kimitobo/Lemonster/Photos/Lemonster_TW.jpg

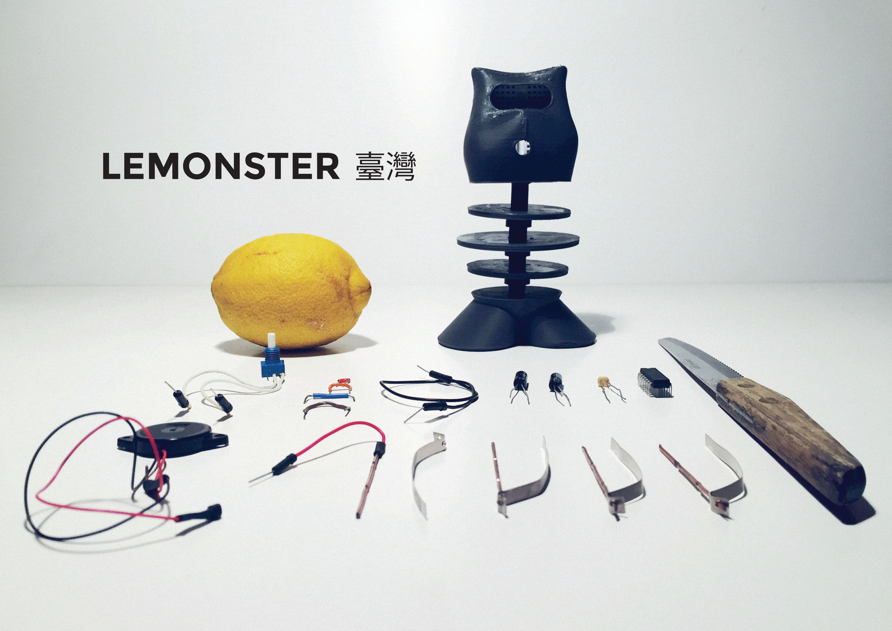
Photos/Lemonster_TW.jpg
