kimitobo/Lemonster/Laser/Lemonster_Laserbody_11mm_2mm.jpg

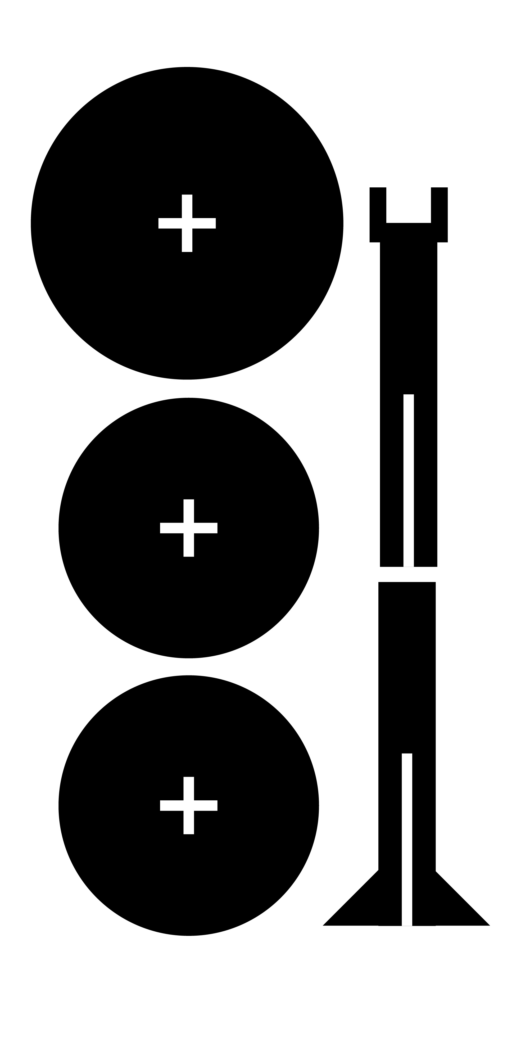
Laser/Lemonster_Laserbody_11mm_2mm.jpg
