kimitobo/Lemonster/Laser/Lemonster_Laserbody_12mm_3mm.jpg

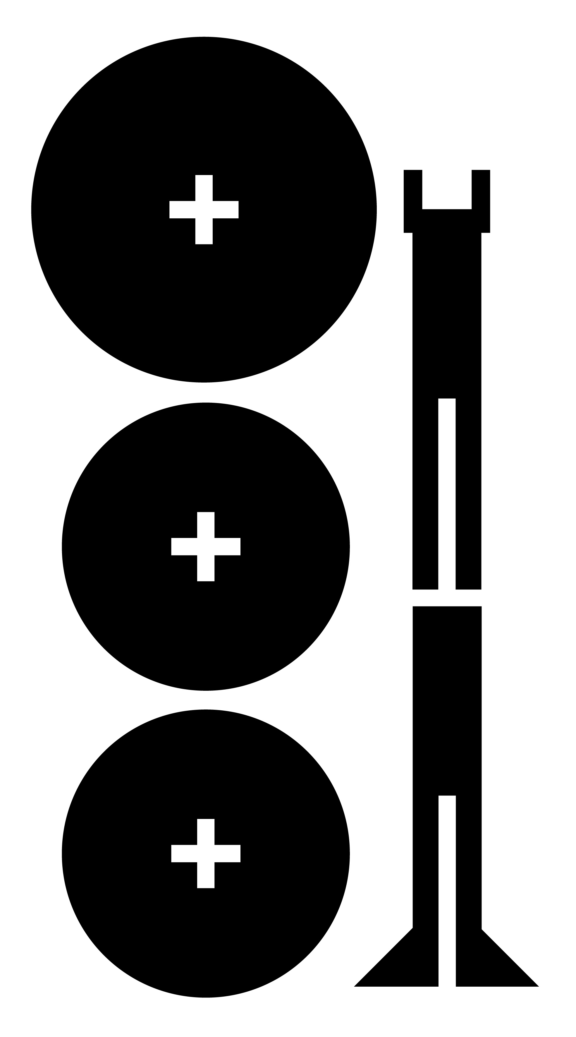
Laser/Lemonster_Laserbody_12mm_3mm.jpg
