kimitobo/Lemonster/STL/Lemonster_1_0_collection_10_5mm-Feet_10_5mm_cross.stl

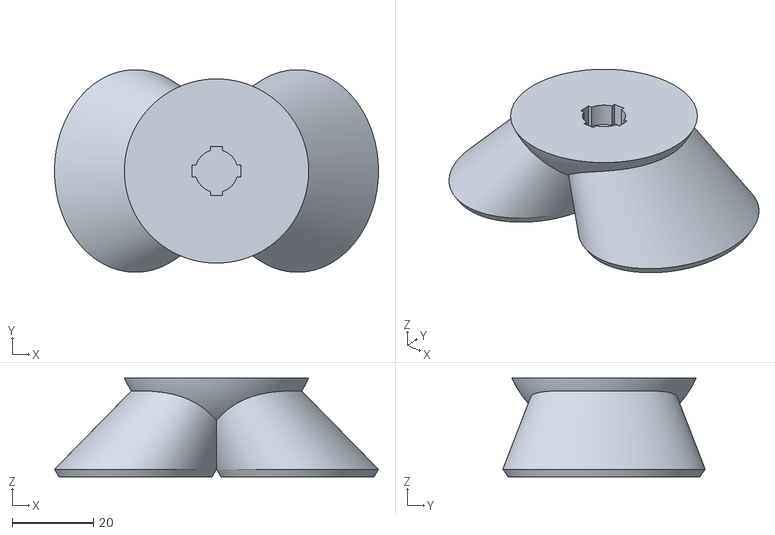
[picture p4: CAD file, 2015-09-28]
STL/Lemonster_1_0_collection_10_5mm-Feet_10_5mm_cross.stl
80.0 x 50.0 x 24.3
