kimitobo/Lemonster/STL/Lemonster_1_0_collection-Head.stl

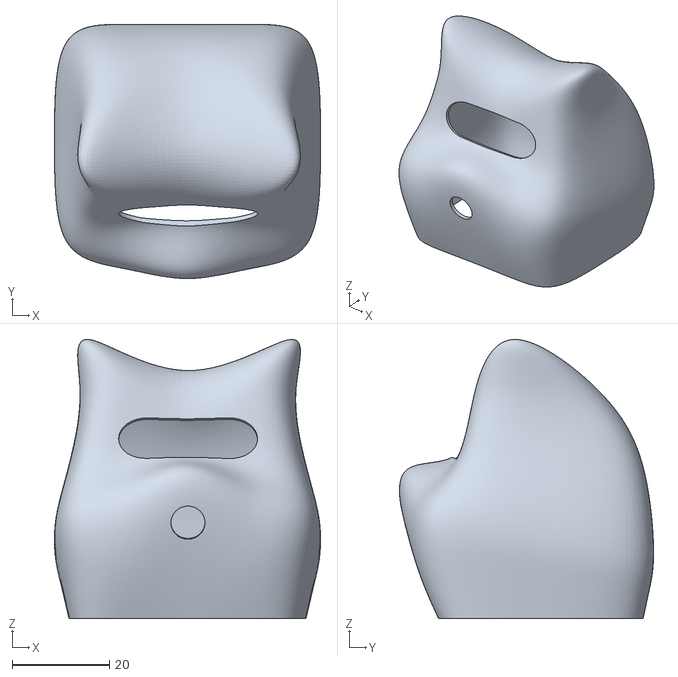
[picture p5: CAD file, 2015-09-28]
STL/Lemonster_1_0_collection-Head.stl
54.6 x 52.2 x 57.3
