kimitobo/Lemonster/STL/Lemonster_1_0_collection_10_5mm-Layer_50mm_10_5mm.stl

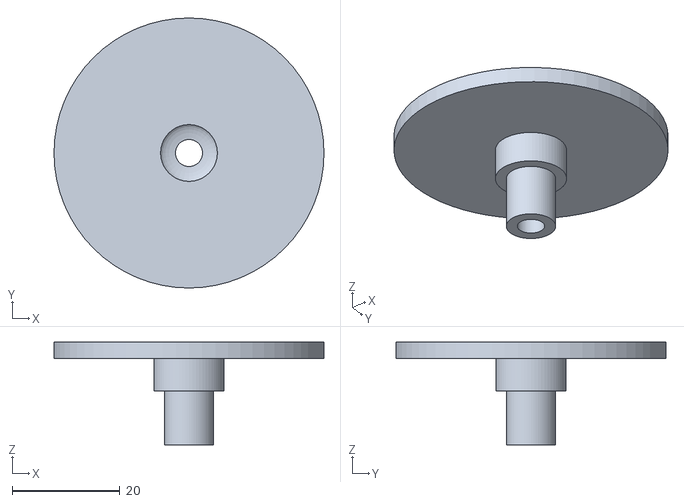
[picture p6: CAD file, 2015-09-28]
STL/Lemonster_1_0_collection_10_5mm-Layer_50mm_10_5mm.stl
50.0 x 50.0 x 19.0
