kimitobo/Lemonster/STL/Lemonster_1_0_collection_10_5mm-LaserTestSocket.stl

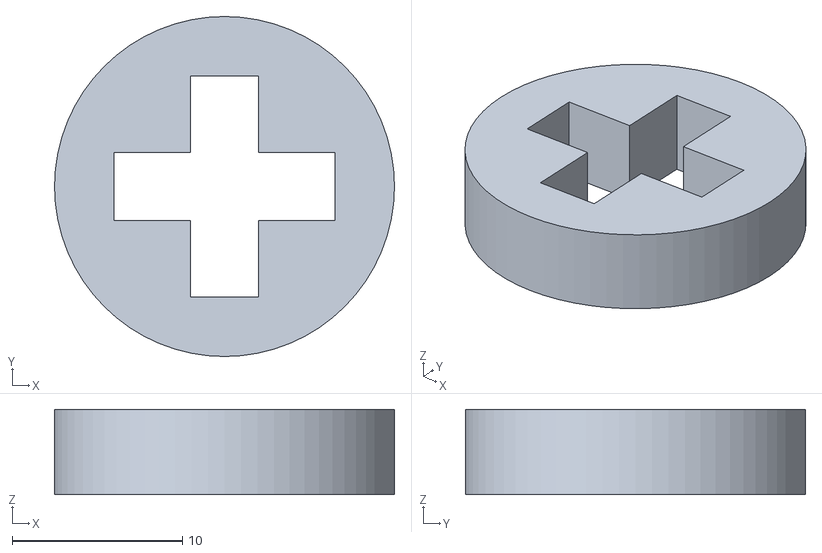
[picture p7: CAD file, 2015-09-28]
STL/Lemonster_1_0_collection_10_5mm-LaserTestSocket.stl
20.0 x 20.0 x 5.00
