kimitobo/Lemonster/STL/Lemonster_1_0_collection_10_5mm-Layer_60mm_10_5mm.stl

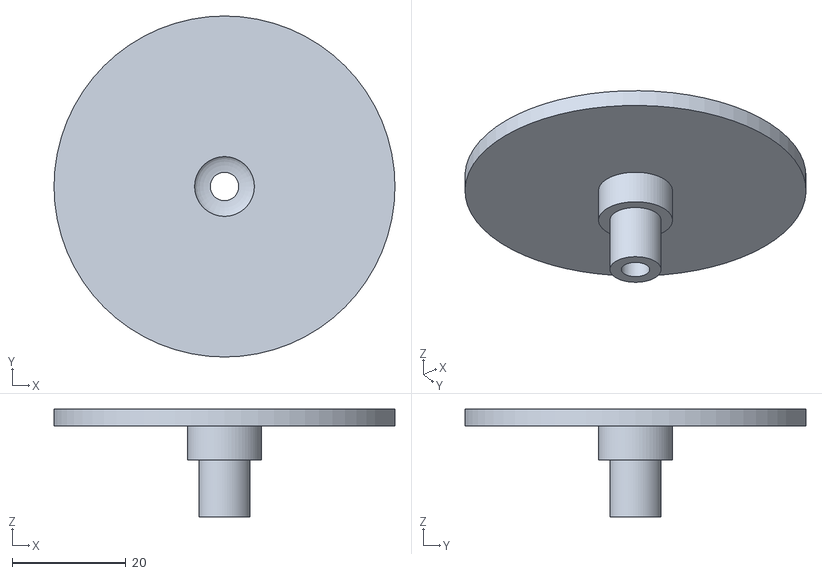
[picture p8: CAD file, 2015-09-28]
STL/Lemonster_1_0_collection_10_5mm-Layer_60mm_10_5mm.stl
60.0 x 60.0 x 19.0
