kimitobo/Lemonster/STL/Lemonster_1_0_collection-Neck.stl

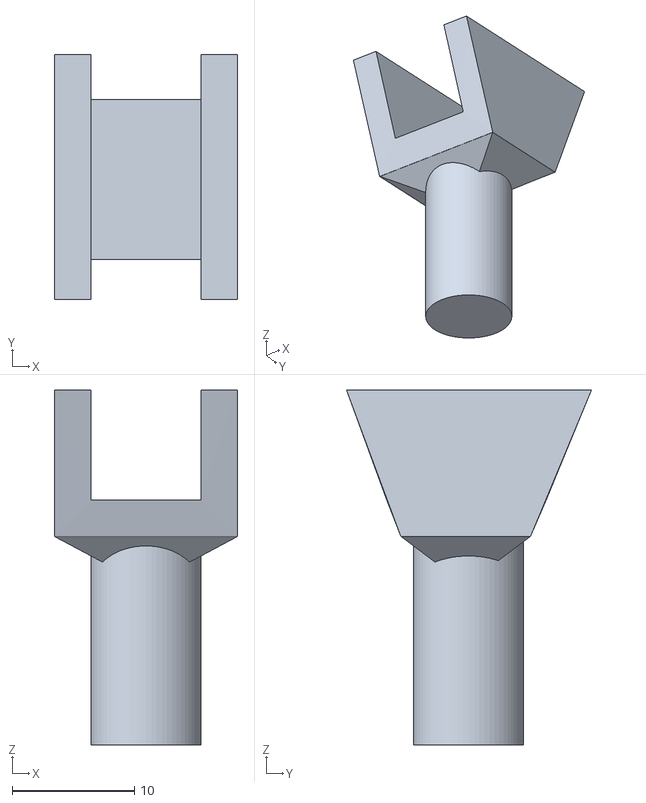
[picture p9: CAD file, 2015-09-28]
STL/Lemonster_1_0_collection-Neck.stl
15.0 x 20.0 x 29.0
