kimitobo/Lemonster/(list of files, cad)

Other CAD files:
Blender/Lemonster_1_0_collection_10_5mm.blend
