kimitobo/Lemonster/(commit log)

2015-09-28 Start of a project, added first set of STL files
    [Lemonster_1_0_collection-Head.stl, Lemonster_1_0_collection-Neck.stl, Lemonster_1_0_collection_10_5mm-Feet_10_5mm_cross.stl, Lemonster_1_0_collection_10_5mm-LaserTestSocket.stl, Lemonster_1_0_collection_10_5mm-Layer_50mm_10_5mm.stl, Lemonster_1_0_collection_10_5mm-Layer_60mm_10_5mm.stl, Lemonster_1_0_collection_10_5mm.blend]
2015-09-28 second set
    [Lemonster_1_0_collection_10_5mm.blend]
